TinyCircuits/TinyCircuits-TinyShield-Compass-ASD2613/design_files/ASD2613_Rev1.pdf

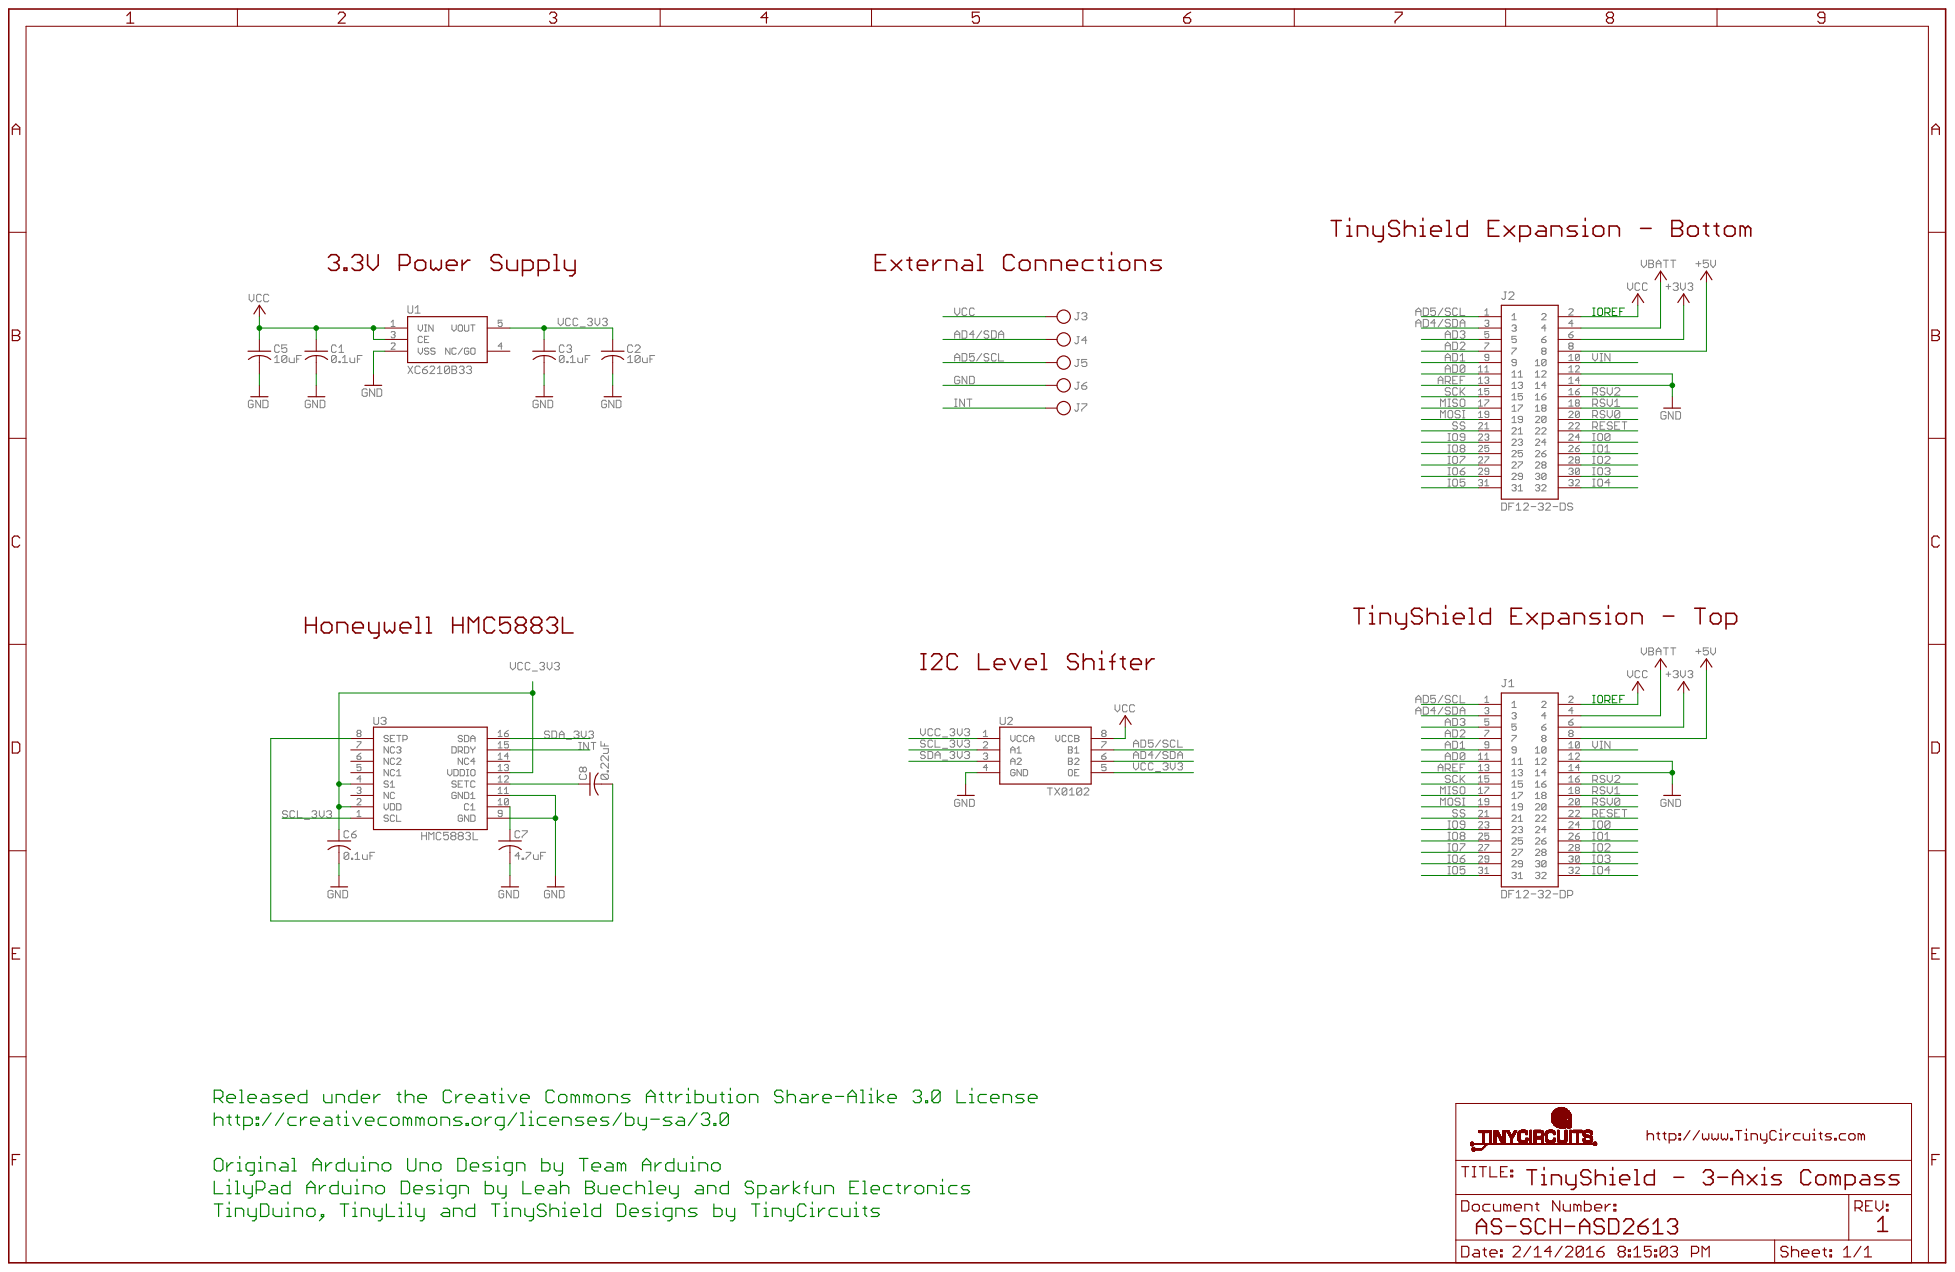
[picture p1: page 1]
