TinyCircuits/TinyCircuits-TinyShield-Compass-ASD2613/design_files/ASD2613.brd

## EAGLE design design_files/ASD2613.brd (2014-02-17)

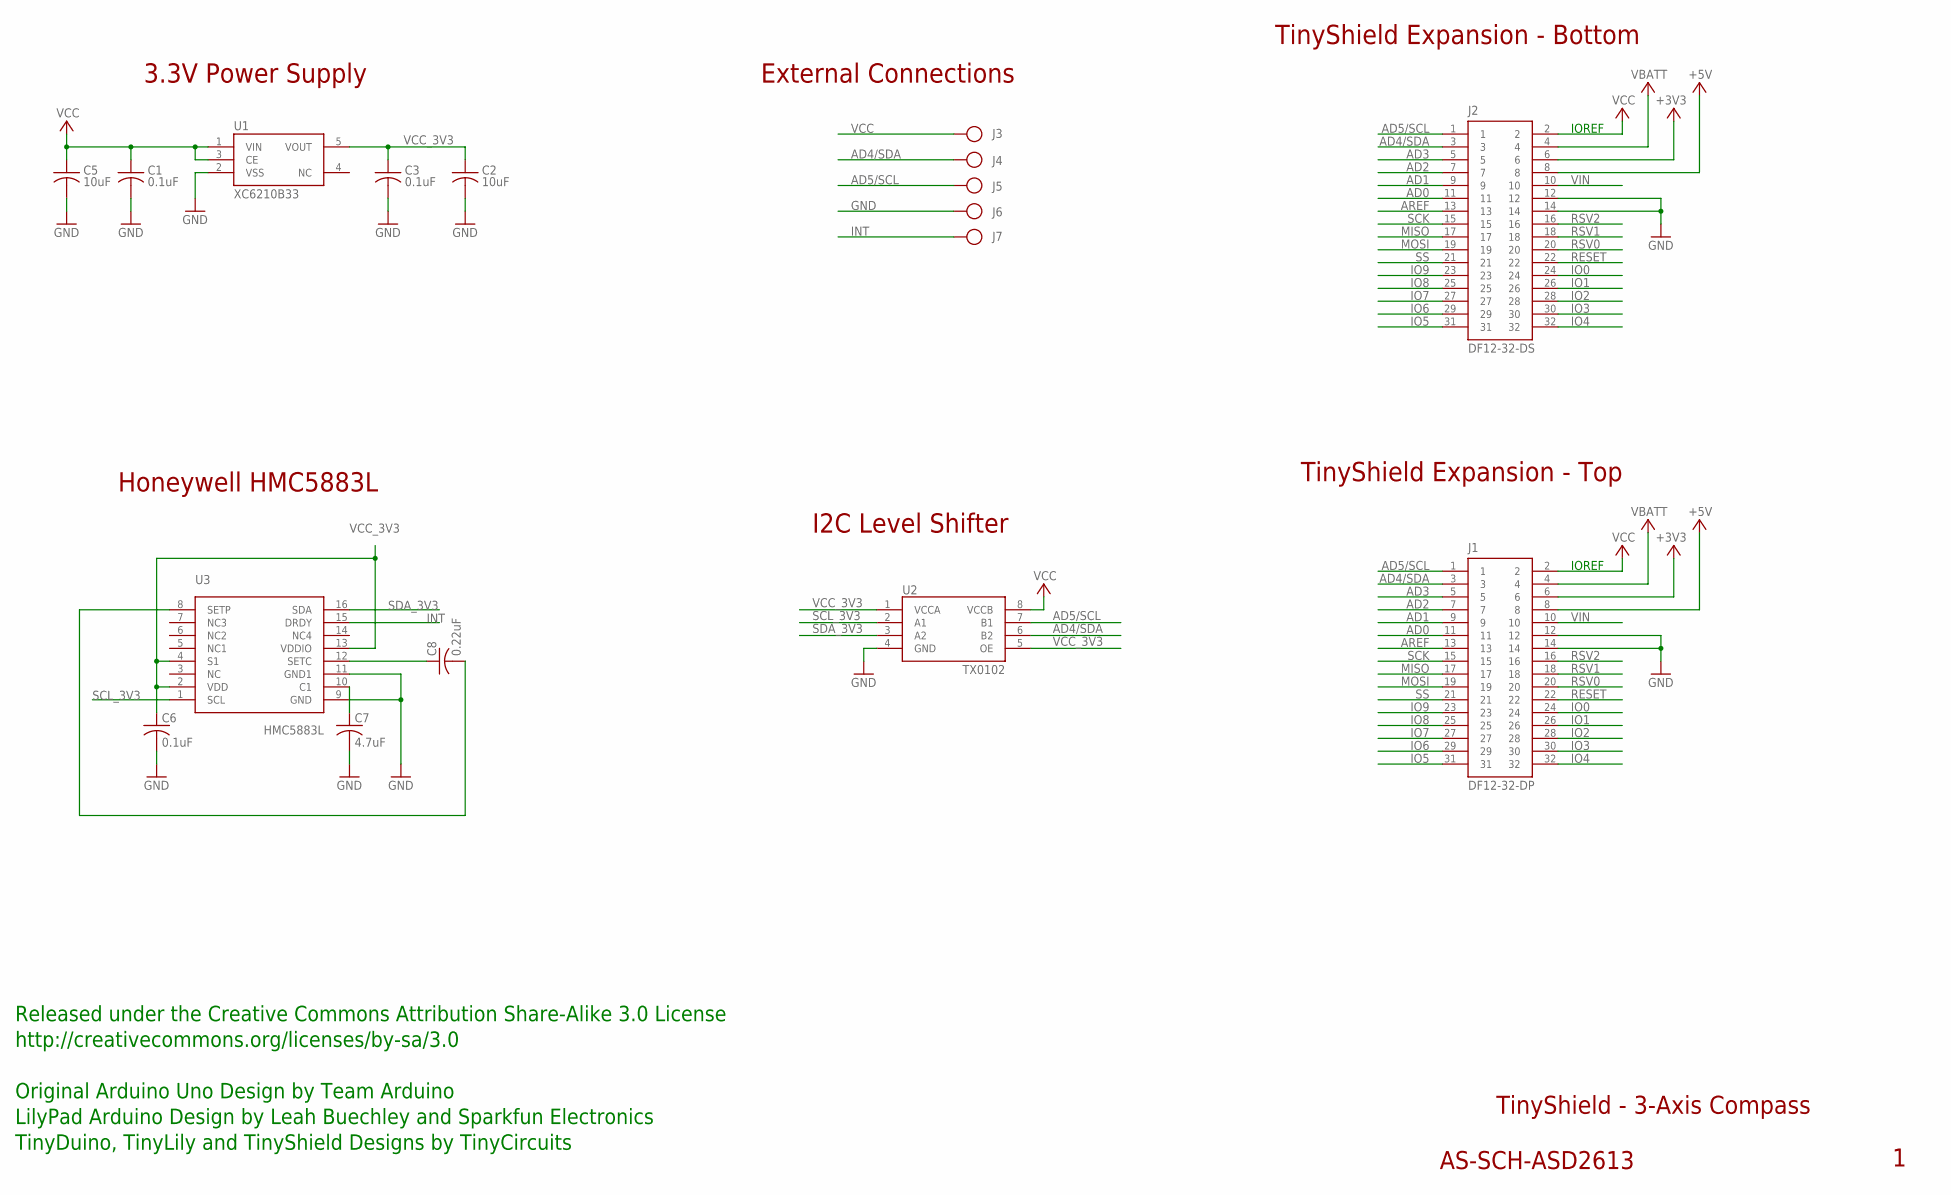
[picture p2: schematic ASD2613.sch]

Parts:
C1, C3: 0.1uF; C0402; PARTNO AS-ITM-00008
C2: 10uF; C0805; PARTNO AS-ITM-00045
C5: 10uF; C0805
C6: 0.1uF; C0402
C7: 4.7uF; C0603
C8: 0.22uF; 0402
J1: DF12-32-DP; PARTNO AS-ITM-00015
J2: DF12-32-DS; PARTNO AS-ITM-00012
J3, J4, J5, J6, J7: PIN_1X.1"; 1X.1"
U1: XC6210B33; SOT-25
U2: TX0102; DQE(R-PX2SON-N8)
U3: HMC5883L

Connections:
+3V3: J1.6, J2.6
+5V: J1.8, J2.8
AD0: J1.11, J2.11
AD1: J1.9, J2.9
AD2: J1.7, J2.7
AD3: J1.5, J2.5
AD4/SDA: J1.3, J2.3, J4.1, U2.6 (B2)
AD5/SCL: J1.1, J2.1, J5.1, U2.7 (B1)
AREF: J1.13, J2.13
GND: C1.2, C2.2, C3.2, C5.2, C6.2, C7.2, J1.12, J1.14, J2.12, J2.14, J6.1, U1.2 (VSS), U2.4 (GND), U3.9 (GND), U3.11 (GND1)
INT: J7.1, U3.15 (DRDY)
IO0: J1.24, J2.24
IO1: J1.26, J2.26
IO2: J1.28, J2.28
IO3: J1.30, J2.30
IO4: J1.32, J2.32
IO5: J1.31, J2.31
IO6: J1.29, J2.29
IO7: J1.27, J2.27
IO8: J1.25, J2.25
IO9: J1.23, J2.23
MISO: J1.17, J2.17
MOSI: J1.19, J2.19
unnamed: C8.2, U3.8 (SETP)
unnamed: C8.1, U3.12 (SETC)
unnamed: C7.1, U3.10 (C1)
RESET: J1.22, J2.22
RSV0: J1.20, J2.20
RSV1: J1.18, J2.18
RSV2: J1.16, J2.16
SCK: J1.15, J2.15
SCL_3V3: U2.2 (A1), U3.1 (SCL)
SDA_3V3: U2.3 (A2), U3.16 (SDA)
SS: J1.21, J2.21
VBATT: J1.4, J2.4
VCC: C1.1, C5.1, J1.2, J2.2, J3.1, U1.1 (VIN), U1.3 (CE), U2.8 (VCCB)
VCC_3V3: C2.1, C3.1, C6.1, U1.5 (VOUT), U2.1 (VCCA), U2.5 (OE), U3.2 (VDD), U3.4 (S1), U3.13 (VDDIO)
VIN: J1.10, J2.10

Notes on the sheet:
TinyShield Expansion - Bottom
TinyShield - 3-Axis Compass
AS-SCH-ASD2613
TinyShield Expansion - Top
IOREF
Released under the Creative Commons Attribution Share-Alike 3.0 License
http://creativecommons.org/licenses/by-sa/3.0
LilyPad Arduino Design by Leah Buechley and Sparkfun Electronics
TinyDuino, TinyLily and TinyShield Designs by TinyCircuits
Original Arduino Uno Design by Team Arduino
External Connections
3.3V Power Supply
I2C Level Shifter
Honeywell HMC5883L

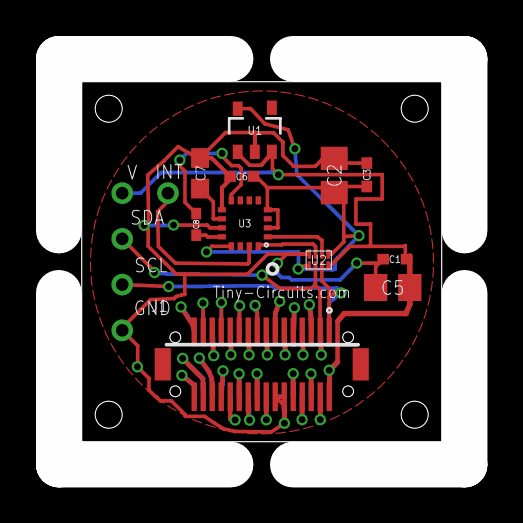
[picture p3: board ASD2613.brd from above]

Board: 2 copper layers, 20.0 x 20.0 mm, 18 parts (1 on the bottom side), 38 nets.

Other parts of the board:
U$1: DOCFIELD-TINYCIRCUITS-PCB
