TinyCircuits/TinyCircuits-TinyShield-Compass-ASD2613/(commit log)

2017-03-22 Added sample sketch
2019-01-02 update format
    [ASD2613.brd, ASD2613.sch]
